etherkit/CRX1/documentation/CRX1 Schematics.pdf

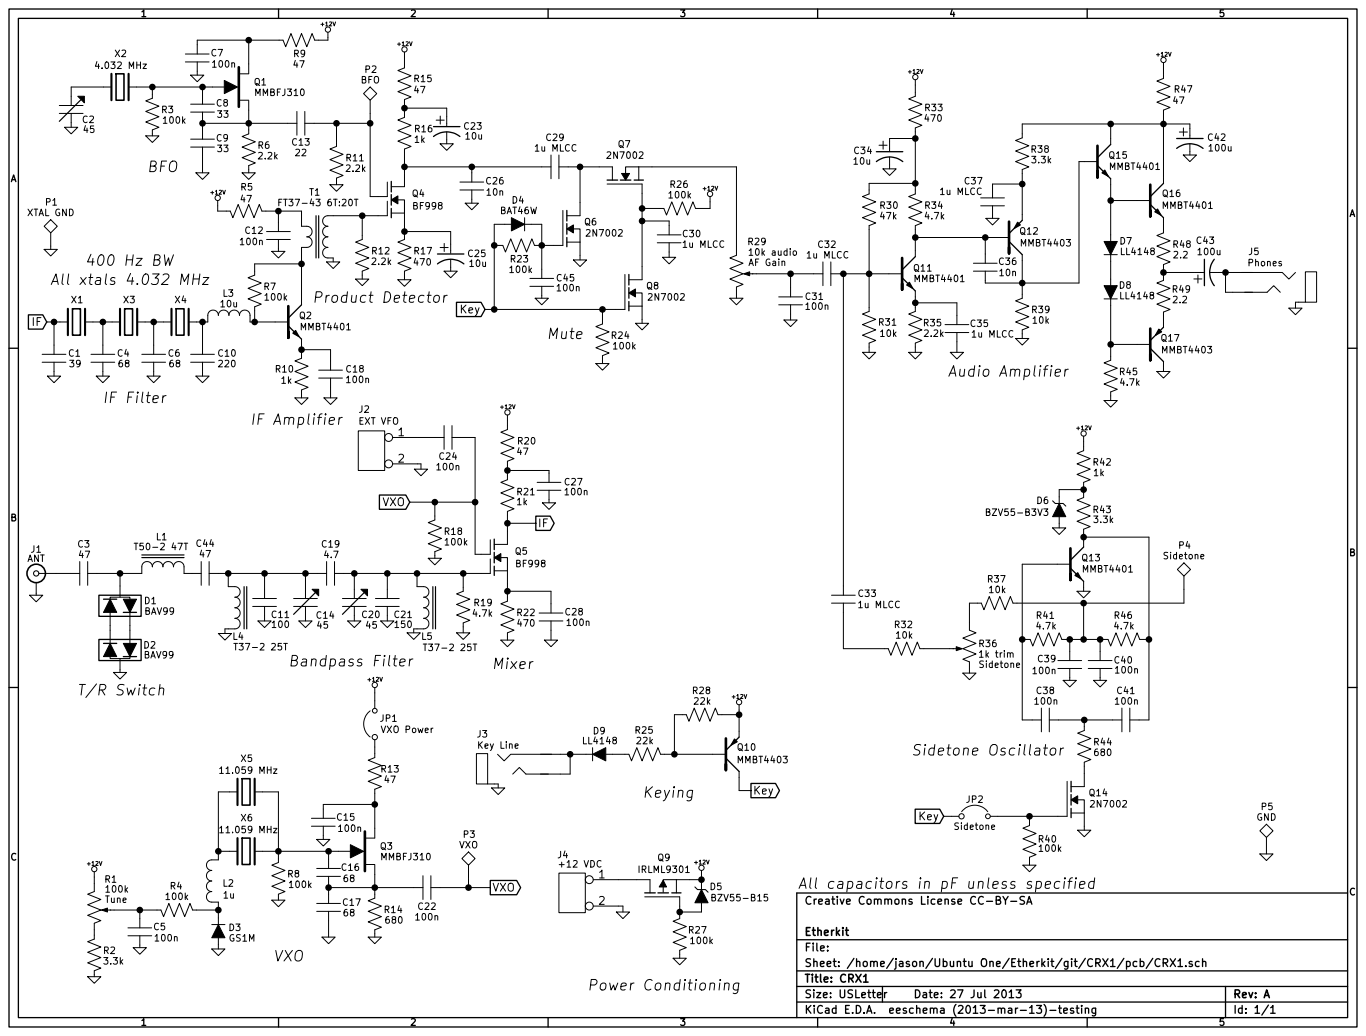
[picture p1: page 1]

C Creative Commons License CC-BY-SA

Etherkit Sheet: /home/jason/Ubuntu One/Etherkit/git/CRX1/pcb/CRX1.sch File: Title: CRX1

KiCad E.D.A. eeschema (2013-mar-13)-testing Date: 27 Jul 2013
