etherkit/CRX1/pcb/CRX1.kicad_pcb

## KiCad design pcb/CRX1.kicad_pcb (2013-06-09)

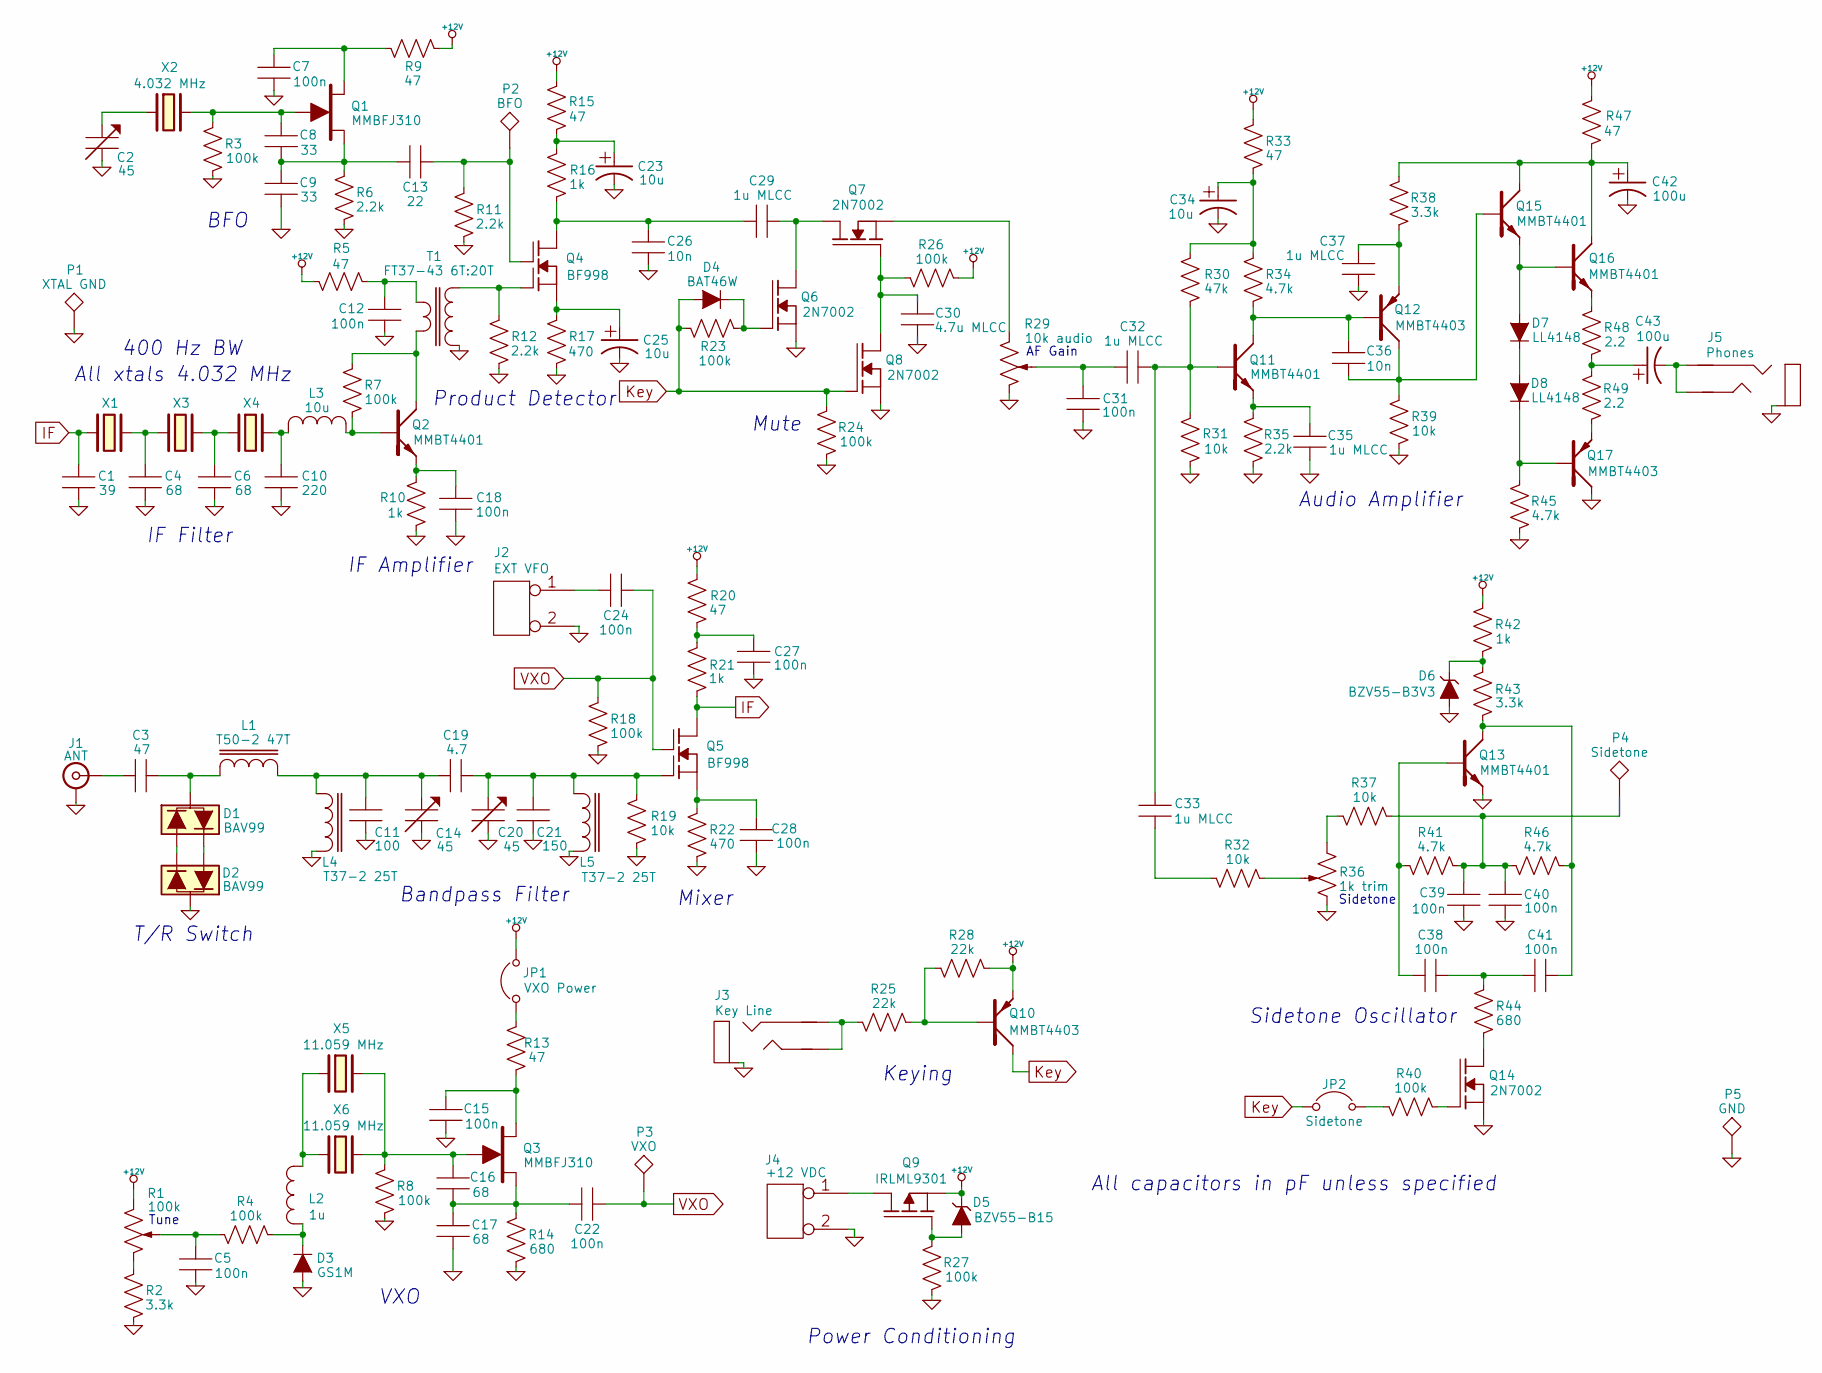
[picture p2: schematic CRX1.sch]

Parts:
C1: 39
C2, C14, C20: 45
C3: 47
C4, C6, C16, C17: 68
C5, C7, C12, C15, C18, C22, C24, C27, C28, C31, C38, C39, C40, C41: 100n
C8, C9: 33
C10: 220
C11: 100
C13: 22
C19: 4.7
C21: 150
C23, C25, C34: 10u
C26, C36: 10n
C29, C32, C33, C35, C37: 1u MLCC
C30: 4.7u MLCC
C42, C43: 100u
D1, D2: BAV99
D3: GS1M
D4: BAT46W
D5: BZV55-B15
D6: BZV55-B3V3
D7, D8: LL4148
J1: ANT
J2: EXT VFO
J3: Key Line
J4: +12 VDC
J5: Phones
JP1: VXO Power
JP2: Sidetone
L1: T50-2 47T
L2: 1u
L3: 10u
L4, L5: T37-2 25T
P1: XTAL GND
P2: BFO
P3: VXO
P4: Sidetone
P5: GND
Q1, Q3: MMBFJ310
Q2, Q11, Q13, Q15, Q16: MMBT4401
Q4, Q5: BF998
Q6, Q7, Q8, Q14: 2N7002
Q9: IRLML9301
Q10, Q12, Q17: MMBT4403
R1, R3, R4, R7, R8, R18, R23, R24, R26, R27, R40: 100k
R2, R38, R43: 3.3k
R5, R9, R13, R15, R20, R33, R47: 47
R6, R11, R12, R35: 2.2k
R10, R16, R21, R42: 1k
R14, R44: 680
R17, R22: 470
R19, R31, R32, R37, R39: 10k
R25, R28: 22k
R29: 10k audio
R30: 47k
R34, R41, R45, R46: 4.7k
R36: 1k trim
R48, R49: 2.2
T1: FT37-43 6T:20T
X1, X2, X3, X4: 4.032 MHz
X5, X6: 11.059 MHz

Connections:
+12V: D5.2 (K), JP1.2, Q9.1 (S), Q10.1 (E), R1.1, R5.1, R9.2, R15.1, R20.1, R26.2, R28.2, R33.1, R42.1, R47.1
IF: C1.1, Q5.2 (D), R21.2, X1.1
Key: D4.1 (A), JP2.1, Q8.2 (G), Q10.3 (C), R23.1, R24.1
unnamed: C11.1, C14.1, C19.1, L1.2, L4.1
unnamed: C19.2, C20.1, C21.1, L5.1, Q5.4 (G1), R19.1
unnamed: C28.1, Q5.1 (S), R22.1
unnamed: C10.1, L3.1, X4.2
unnamed: C6.1, X3.2, X4.1
unnamed: C3.1, J1.1 (In)
unnamed: C3.2, D1.3, L1.1
unnamed: D1.2, D2.1
unnamed: D1.1, D2.2
unnamed: C27.1, R20.2, R21.1
unnamed: C12.1, R5.2, T1.3
unnamed: Q2.3 (C), R7.1, T1.4
unnamed: C8.2, C9.1, C13.1, Q1.1 (S), R6.1
unnamed: C7.1, Q1.3 (D), R9.1
unnamed: C8.1, Q1.2 (G), R3.1, X2.2
unnamed: C2.1, X2.1
unnamed: C4.1, X1.2, X3.1
unnamed: L3.2, Q2.2 (B), R7.2
unnamed: C18.1, Q2.1 (E), R10.1
unnamed: C15.1, Q3.3 (D), R13.2
unnamed: Q10.2 (B), R25.2, R28.1
unnamed: L2.1, X5.1, X6.1
unnamed: J3.1, J3.2, R25.1
unnamed: C24.1, J2.1
unnamed: D3.2 (K), L2.2, R4.2
unnamed: C5.1, R1.2, R4.1
unnamed: R1.3, R2.1
unnamed: J4.1, Q9.3 (D)
unnamed: C43.2, J5.1, J5.2
unnamed: JP1.1, R13.1
unnamed: C16.1, Q3.2 (G), R8.1, X5.2, X6.2
unnamed: C16.2, C17.1, C22.1, Q3.1 (S), R14.1
unnamed: C33.2, R32.1
unnamed: C37.1, Q12.1 (E), R38.2
unnamed: C32.2, C33.1, Q11.2 (B), R30.2, R31.1
unnamed: C31.1, C32.1, R29.2
unnamed: C35.1, Q11.1 (E), R35.1
unnamed: C36.1, Q11.3 (C), Q12.2 (B), R34.2
unnamed: C34.1, R30.1, R33.2, R34.1
unnamed: R36.1, R37.1
unnamed: C39.1, C40.1, P4.1, R37.2, R41.2, R46.1
unnamed: R32.2, R36.2
unnamed: JP2.2, R40.1
unnamed: C38.1, Q13.2 (B), R41.1
unnamed: C41.2, Q13.3 (C), R43.2, R46.2
unnamed: Q14.2 (G), R40.2
unnamed: Q14.3 (D), R44.2
unnamed: C36.2, Q12.3 (C), Q15.2 (B), R39.1
unnamed: C43.1, R48.2, R49.1
unnamed: Q17.1 (E), R49.2
unnamed: D8.2 (K), Q17.2 (B), R45.1
unnamed: Q16.1 (E), R48.1
unnamed: D7.1 (A), Q15.1 (E), Q16.2 (B)
unnamed: C42.1, Q15.3 (C), Q16.3 (C), R38.1, R47.2
unnamed: D7.2 (K), D8.1 (A)
unnamed: C13.2, P2.1, Q4.3 (G2), R11.1
unnamed: D4.2 (K), Q6.2 (G), R23.2
unnamed: C29.2, Q6.3 (D), Q7.3 (D)
unnamed: C23.1, R15.2, R16.1
unnamed: Q4.4 (G1), R12.1, T1.1
unnamed: C26.1, C29.1, Q4.2 (D), R16.2
unnamed: C25.1, Q4.1 (S), R17.1
unnamed: C38.2, C41.1, R44.1
unnamed: Q7.1 (S), R29.1
unnamed: D6.2 (K), R42.2, R43.1
unnamed: C30.1, Q7.2 (G), Q8.3 (D), R26.1
VXO: C22.2, C24.2, P3.1, Q5.3 (G2), R18.1

Notes on the sheet:
All capacitors in pF unless specified
400 Hz BW
All xtals 4.032 MHz
Tune
AF Gain
VXO
Keying
Sidetone Oscillator
T/R Switch
Bandpass Filter
Mixer
IF Filter
IF Amplifier
Product Detector
Mute
Audio Amplifier
Sidetone
Power Conditioning
BFO

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
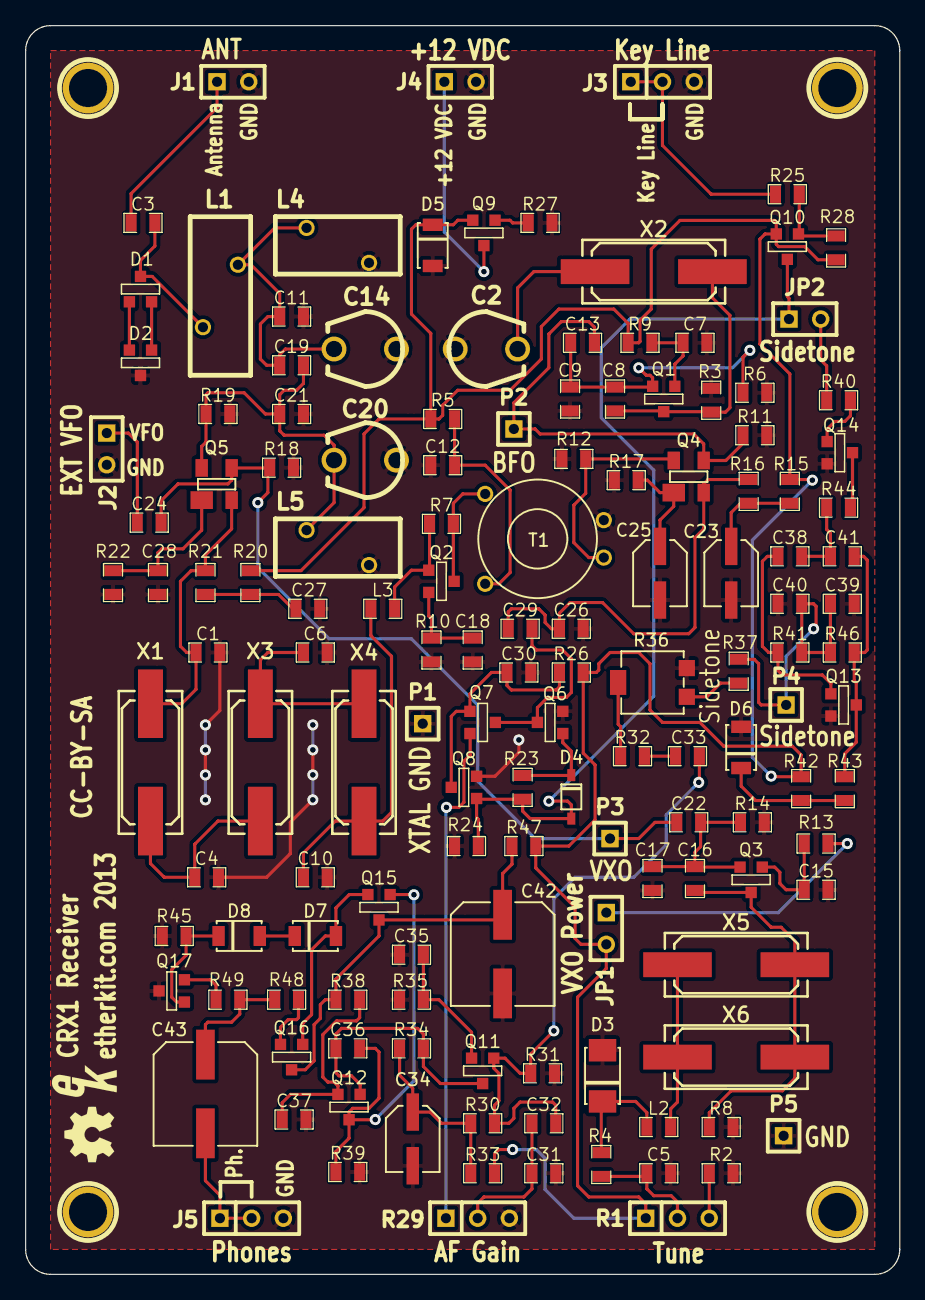
[picture p3: board CRX1.kicad_pcb from above]

Board: 2 copper layers, 70.0 x 100.0 mm, 146 parts (0 on the bottom side), 72 nets.

Other parts of the board:
1PIN, 1PIN#2, 1PIN#3, 1PIN#4: P***; 1pin
Ref**: Val**; EtherkitLogoSmall
